gtjennings1/Himax-Camera-and-Mic-UPDuino-v2.0-Adapter/PCB/Rev A/PICTURES/W45302ASS60(1).jpg

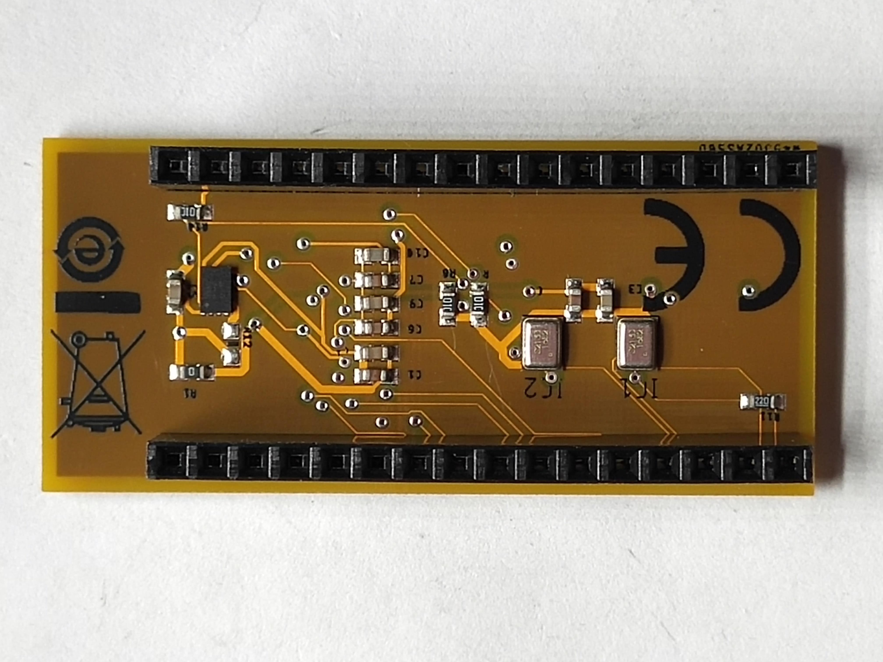
PCB/Rev A/PICTURES/W45302ASS60(1).jpg
