gtjennings1/Himax-Camera-and-Mic-UPDuino-v2.0-Adapter/README.md

# Himax-Camera-and-Mic-UPDuino-v2.0-Adapter
