gtjennings1/Himax-Camera-and-Mic-UPDuino-v2.0-Adapter/PCB/Rev A/BOM/UPDuino Camera Adapter himax.xlsx

25SETS |  |  | QTY | Part | Value | Device | Package | Description | PROD_ID | VALUE
$0.052 | $0.210 |  | 4 | C1, C2, C6, C7 | 0.1uF | 0.1UF-0603-25V-(+80/-20%) | 603 | 0.1碌F | ceramic | capacitors | CAP-00810 | 0.1uF
$0.021 | $0.021 |  | 1 | C3 | 200pF | 200PF-0603-6.3V-20% | 603 | 10.0碌F | ceramic | capacitors | CAP-11015 | 10uF
$0.105 | $0.420 |  | 4 | C4, C9, C10, C5 | 10uF | 10UF-0603-6.3V-20% | 603 | 10.0碌F | ceramic | capacitors | CAP-11015 | 10uF
$0.052 | $0.315 | offer is LTST-C190KGKT | 6 | D1,D2, D3, D4, D5, D6 | GREEN | LED-GREEN0603 | LED-0603 | Various | green | LEDs | DIO-00821 | GREEN
$2.877 | $5.754 | SPH0645LM4H-B 5-7work days | 2 | IC1, IC2 | MIC_I2S_SPH0645 | MIC_I2S_SPH0645 | SPH0645LM4H
$1.050 | $1.050 | 5037722410 | 1 | J | MOLEX-5037722410_MOLEX | MOLEX-5037722410_MOLEX
$0.126 | $0.252 | female 1*161pin 2.54mm height 8.5mm NOTE: J1 and J2 (0.1" female headers) should be installed on the bottom side of the board | 2 | J1, J2 | CONN_16 | 1X16 | Multi | connection | point. | Often | used | as | Generic | Header-pin | footprint | for | 0.1 | inch | spaced/style | header | connections
$0.021 | $0.021 |  | 1 | R1 | 0 | RESISTOR0603 | 0603-RES | Resistor
$0.021 | $0.126 |  | 6 | R2, R3, R4, R5, R6, R7 | 1k | RESISTOR0603 | 0603-RES | Resistor
$0.021 | $0.063 |  | 3 | R8, R9, R10 | 10k | RESISTOR0603 | 0603-RES | Resistor
$0.021 | $0.021 |  | 1 | R11 | 22 | RESISTOR0603 | 0603-RES | Resistor
$1.491 | $1.491 | 5-7work days | 1 | U$2 | BU6651NUX-TR | BU6651NUX-TR | BU6651NUX-TR
1 set | $9.744
5 sets | $243.600
