gtjennings1/Himax-Camera-and-Mic-UPDuino-v2.0-Adapter/PCB/Rev A/ORIENTATION FILE/UPDuino Camera Adapter 2 himax bottom.pdf

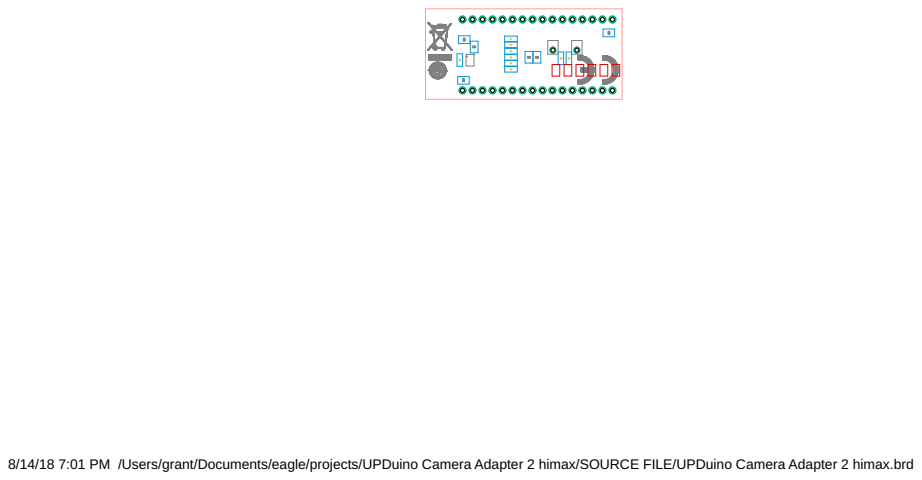
[picture p3: page 1]

8/14/18 7:01 PM /Users/grant/Documents/eagle/projects/UPDuino Camera Adapter 2 himax/SOURCE FILE/UPDuino Camera Adapter 2 himax.brd
