gtjennings1/Himax-Camera-and-Mic-UPDuino-v2.0-Adapter/PCB/Rev A/SOURCE FILE/UPDuino Camera Adapter 2 himax.brd

## EAGLE design PCB/Rev A/SOURCE FILE/UPDuino Camera Adapter 2 himax.brd (2018-09-18)

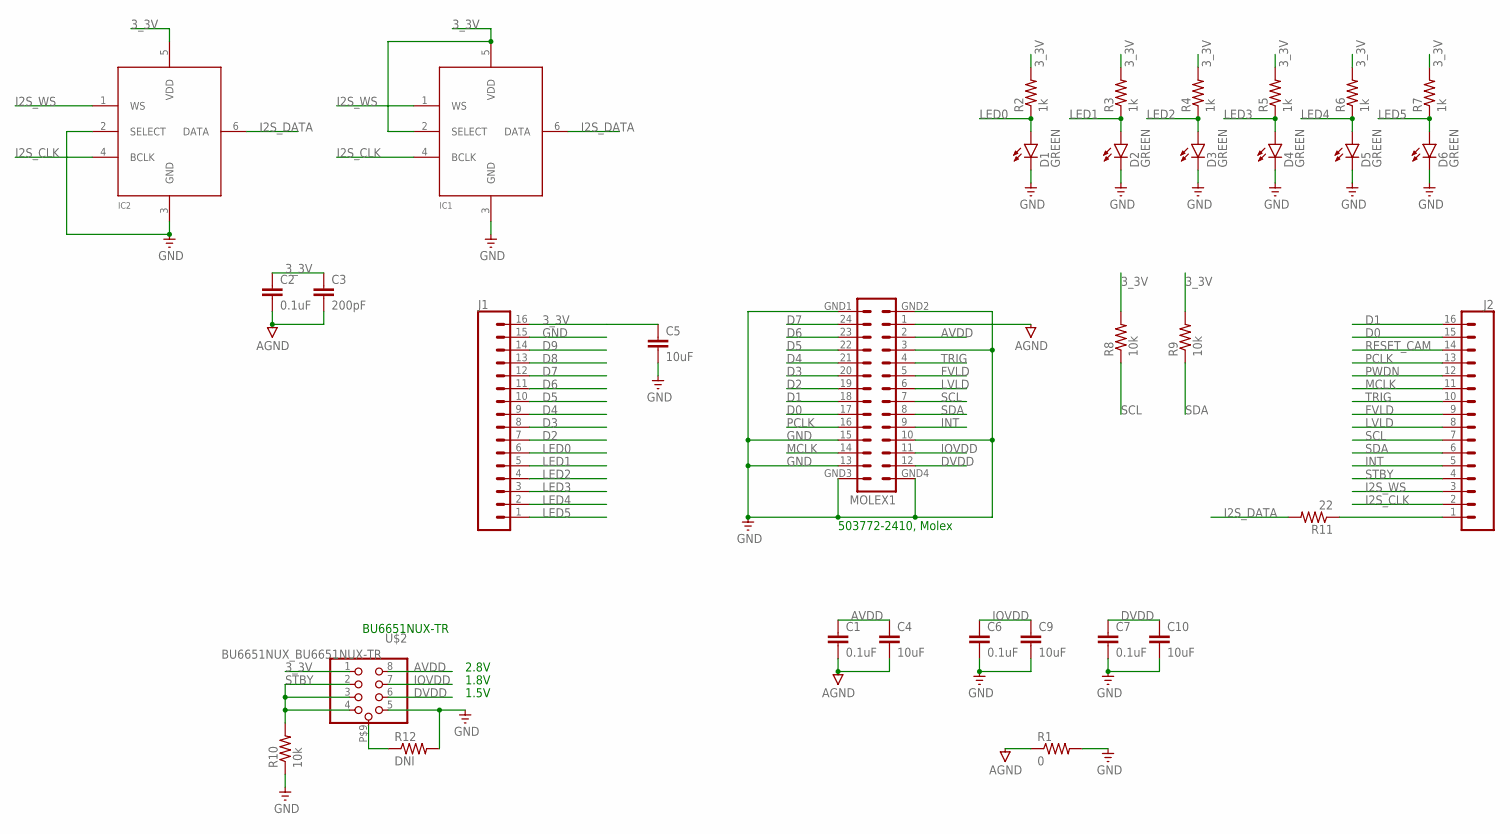
[picture p4: schematic UPDuino Camera Adapter 2 himax.sch]

Parts:
C1, C2, C6, C7: 0.1uF; 0603
C3: 200pF; 0603
C4, C5, C9, C10: 10uF; 0603
D1, D2, D3, D4, D5, D6: GREEN; LED-0603
IC1, IC2: MIC_I2S_SPH0645; SPH0645LM4H
J1, J2: CONN_16; 1X16
MOLEX1: MOLEX-5037722410_MOLEX
R1: 0; 0603-RES
R2, R3, R4, R5, R6, R7: 1k; 0603-RES
R8, R9, R10: 10k; 0603-RES
R11: 22; 0603-RES
R12: DNI; 0603-RES
U$2: BU6651NUX_BU6651NUX-TR

Connections:
3_3V: C2.1, C3.1, C5.1, IC1.2 (SELECT), IC1.5 (VDD), IC2.5 (VDD), J1.16, R2.2, R3.2, R4.2, R5.2, R6.2, R7.2, R8.2, R9.2, U$2.1 (8)
AGND: C1.2, C2.2, C3.2, C4.2, MOLEX1.1, R1.1
AVDD: C1.1, C4.1, MOLEX1.2, U$2.8 (1)
D0: J2.15, MOLEX1.17
D1: J2.16, MOLEX1.18
D2: J1.7, MOLEX1.19
D3: J1.8, MOLEX1.20
D4: J1.9, MOLEX1.21
D5: J1.10, MOLEX1.22
D6: J1.11, MOLEX1.23
D7: J1.12, MOLEX1.24
D8: J1.13
D9: J1.14
DVDD: C7.1, C10.1, MOLEX1.12, U$2.6 (3)
FVLD: J2.9, MOLEX1.5
GND: C5.2, C6.2, C7.2, C9.2, C10.2, D1.C, D2.C, D3.C, D4.C, D5.C, D6.C, IC1.3 (GND), IC2.2 (SELECT), IC2.3 (GND), J1.15, MOLEX1.3, MOLEX1.10, MOLEX1.13, MOLEX1.15, MOLEX1.GND1, MOLEX1.GND2, MOLEX1.GND3, MOLEX1.GND4, R1.2, R10.1, R12.2, U$2.5 (4)
I2S_CLK: IC1.4 (BCLK), IC2.4 (BCLK), J2.2
I2S_DATA: IC1.6 (DATA), IC2.6 (DATA), R11.2
I2S_WS: IC1.1 (WS), IC2.1 (WS), J2.3
INT: J2.5, MOLEX1.9
IOVDD: C6.1, C9.1, MOLEX1.11, U$2.7 (2)
LED0: D1.A, J1.6, R2.1
LED1: D2.A, J1.5, R3.1
LED2: D3.A, J1.4, R4.1
LED3: D4.A, J1.3, R5.1
LED4: D5.A, J1.2, R6.1
LED5: D6.A, J1.1, R7.1
LVLD: J2.8, MOLEX1.6
MCLK: J2.11, MOLEX1.14
unnamed: J2.1, R11.1
unnamed: R12.1, U$2.P$9 (9)
PCLK: J2.13, MOLEX1.16
PWDN: J2.12
RESET_CAM: J2.14
SCL: J2.7, MOLEX1.7, R8.1
SDA: J2.6, MOLEX1.8, R9.1
STBY: J2.4, R10.2, U$2.2 (7), U$2.3 (6), U$2.4 (5)
TRIG: J2.10, MOLEX1.4

Notes on the sheet:
BU6651NUX-TR
503772-2410, Molex
1.8V
1.5V
2.8V

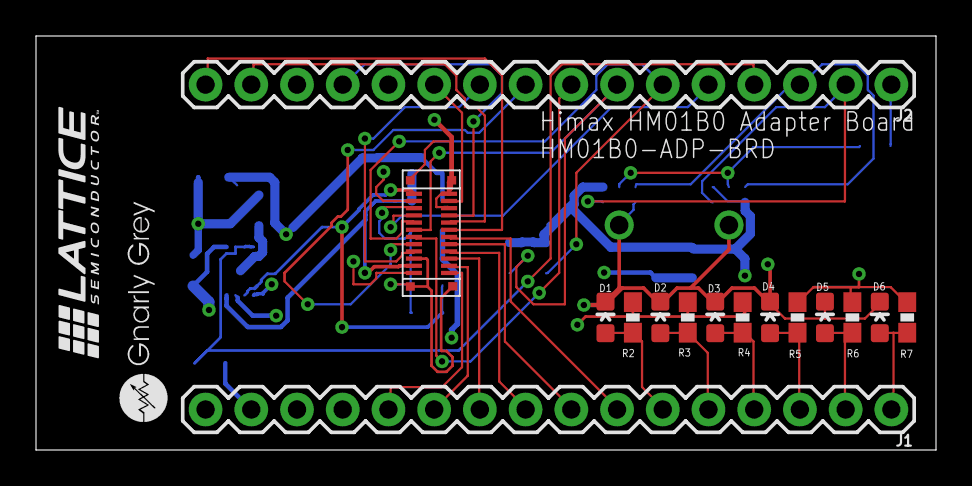
[picture p5: board UPDuino Camera Adapter 2 himax.brd from above]

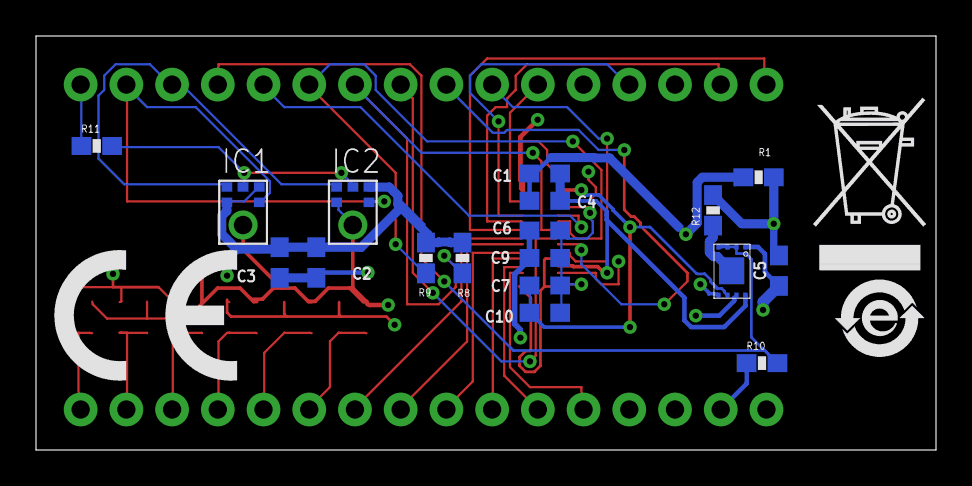
[picture p6: board UPDuino Camera Adapter 2 himax.brd from below]

Board: 4 copper layers, 50.0 x 23.0 mm, 33 parts (18 on the bottom side), 34 nets.
